WaterScope-Org/electronics/LED Defogger board/led_defogger_PCB_with_UV_jlc_bom.csv

Comment | Designator | Footprint | LCSC Part number
1 uF | C1, C2, C3, C4, C5, C6 | C_0805 | C28323
white | D1, D2, D3, D4, D5, D6 | LED_0603 | C389521
UV led | LED1, LED2 | F3500041 | C909692
56 | R1, R2, R3, R4, R5, R6, R7, R8 | R_1210 | C72399
510 | R12, R13, R14, R15, R16, R17 | R_0805 | C17734
10k | R10, R11 | R_0805 | C17414
60.4 | R9, R18 | R_1206 | C247280
DS18B20Z+ | IC3 | SOIC-8_3.9x4.9x1.27P | C695837
NCE6005AS | Q1 | SOP-8_3.9x4.9x1.27P | C126151
TAJB107K006RNJ | C7 | CASE-B_3528 | C16133
