WaterScope-Org/electronics/Incubator Breakout Board/incubator_breakout.step

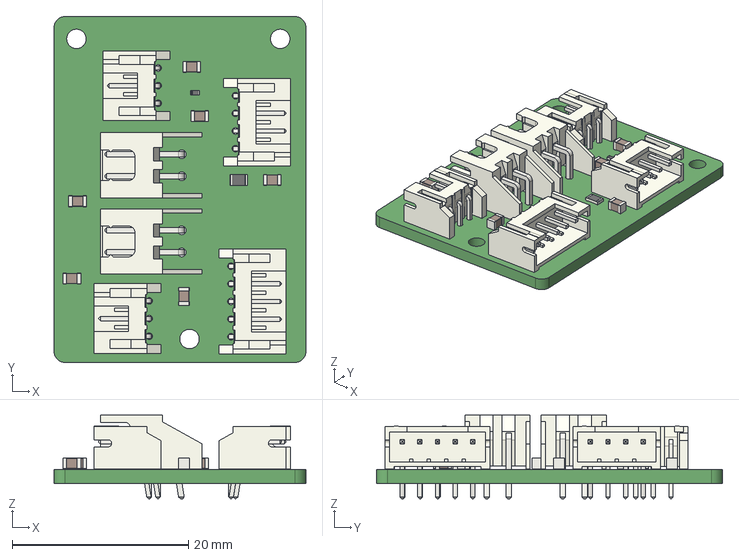
[picture p1: CAD file, 2023-12-29]
Incubator Breakout Board/incubator_breakout.step
28.6 x 39.2 x 9.50 mm
