WaterScope-Org/electronics/LED Defogger board/JST_-_B2B-PH-SM4-TB(LF)(SN).step

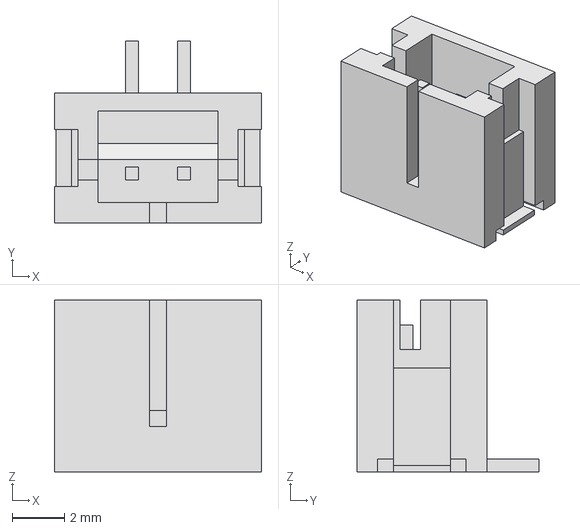
[picture p2: CAD file, 2023-12-29]
LED Defogger board/JST_-_B2B-PH-SM4-TB(LF)(SN).step
7.95 x 7.00 x 6.60 mm
