WaterScope-Org/electronics/Pump Board/cutout.dxf

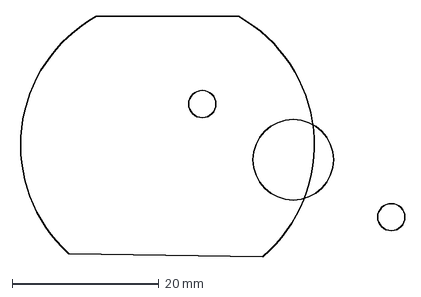
[picture p3: CAD file, 2023-12-29]
Pump Board/cutout.dxf
52.9 x 32.7 mm
