WaterScope-Org/electronics/UVC Sterilisation Boad/Updated Catridge Bottom.step

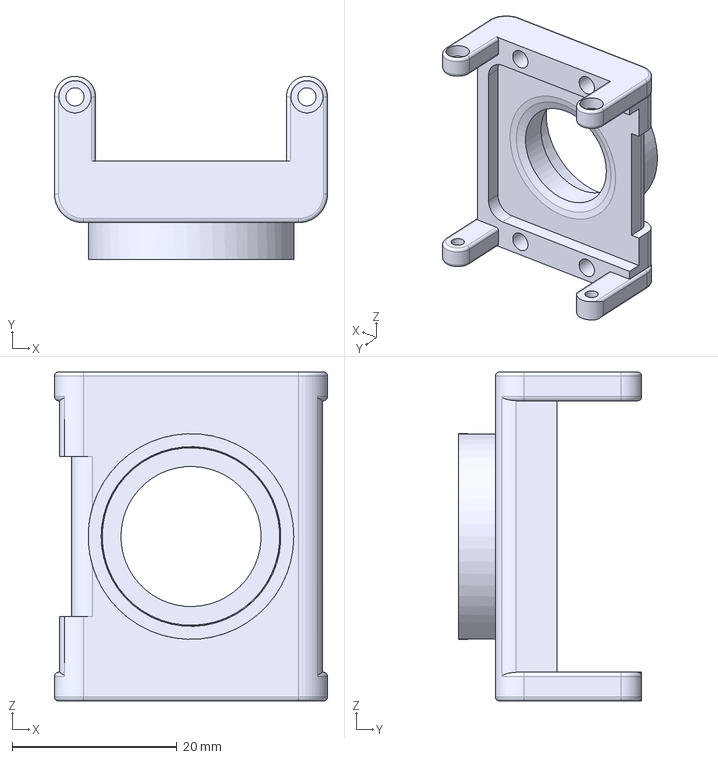
[picture p4: CAD file, 2023-12-29]
UVC Sterilisation Boad/Updated Catridge Bottom.step
33.2 x 22.3 x 40.0 mm
