WaterScope-Org/electronics/LED Defogger board/logo.dxf

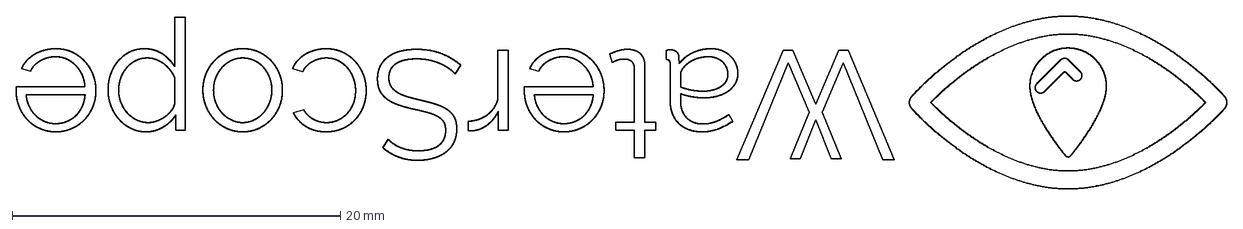
[picture p5: CAD file, 2023-12-29]
LED Defogger board/logo.dxf
73.8 x 10.5 mm
