WaterScope-Org/electronics/Pump Board/Pump PCB.step

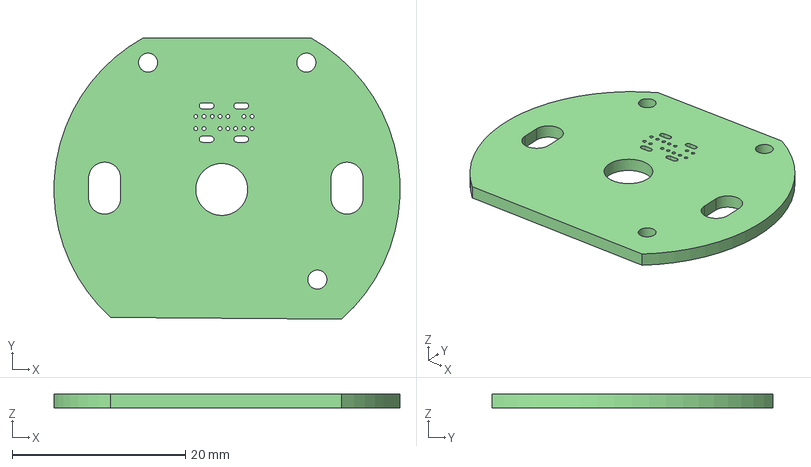
[picture p6: CAD file, 2023-12-29]
Pump Board/Pump PCB.step
40.0 x 32.5 x 1.60 mm
