WaterScope-Org/electronics/UVC Sterilisation Boad/holes.dxf

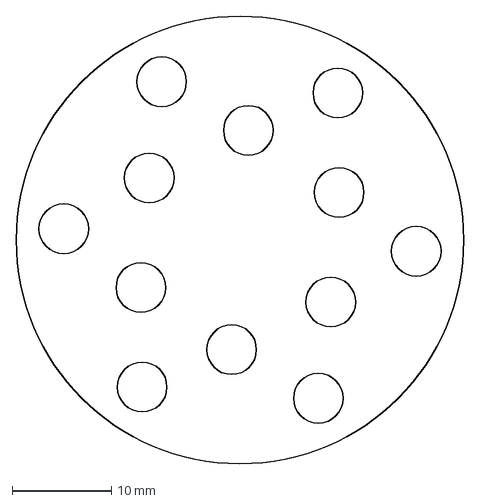
[picture p7: CAD file, 2023-12-29]
UVC Sterilisation Boad/holes.dxf
45.0 x 45.0 mm
