WaterScope-Org/electronics/LED Defogger board/led_defogger_PCB_with_UV.step

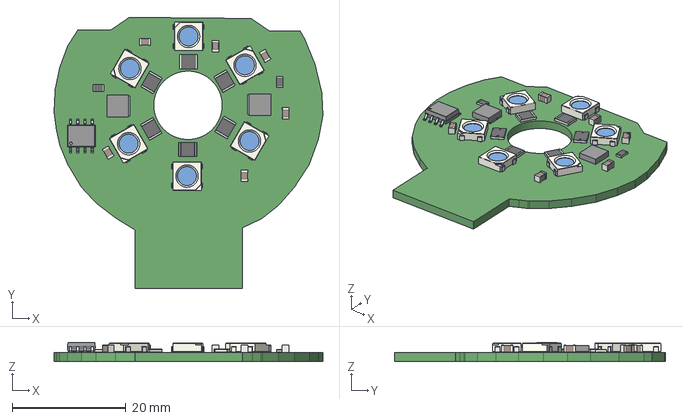
[picture p8: CAD file, 2023-12-29]
LED Defogger board/led_defogger_PCB_with_UV.step
47.2 x 47.6 x 3.40 mm
