WaterScope-Org/electronics/UVC Sterilisation Boad/outline.dxf

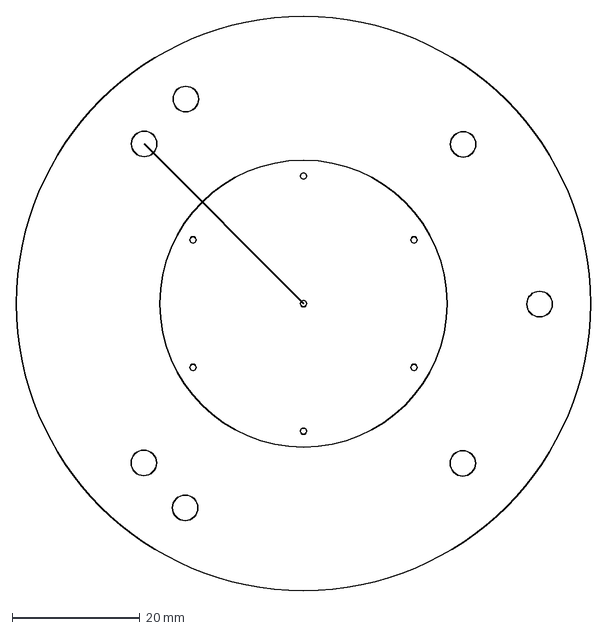
[picture p9: CAD file, 2023-12-29]
UVC Sterilisation Boad/outline.dxf
90.0 x 90.0 mm
