WaterScope-Org/electronics/LED Defogger board/led_defogger_PCB_with_UV_mounting.step

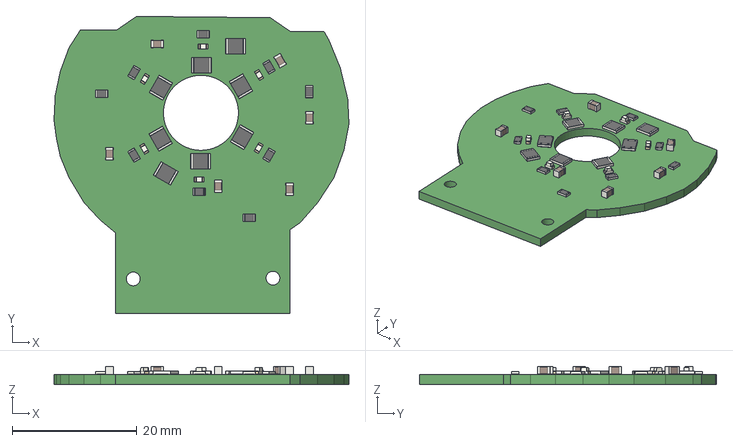
[picture p10: CAD file, 2023-12-29]
LED Defogger board/led_defogger_PCB_with_UV_mounting.step
47.2 x 47.5 x 2.90 mm
