WaterScope-Org/electronics/UVC Sterilisation Boad/Bottom (2).step

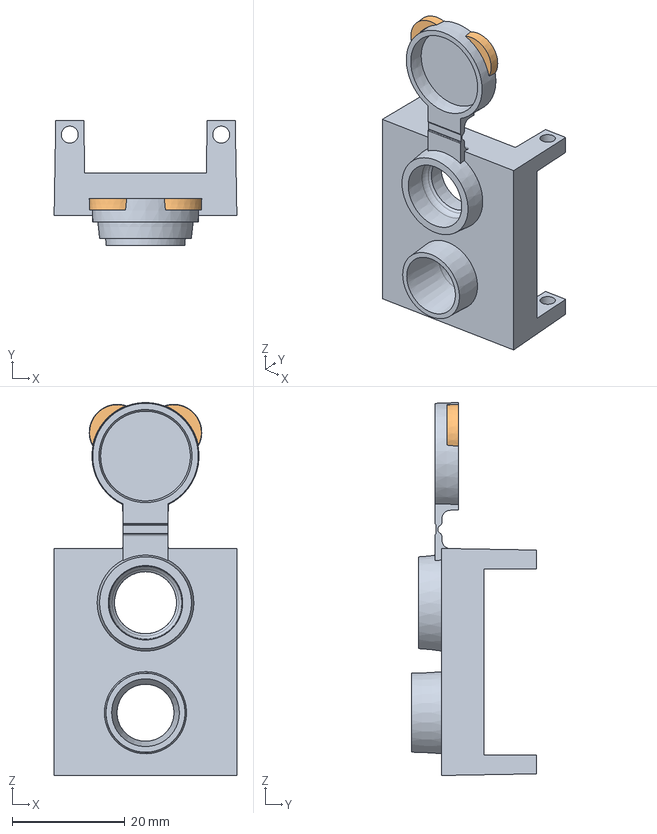
[picture p11: CAD file, 2023-12-29]
UVC Sterilisation Boad/Bottom (2).step
32.4 x 22.1 x 66.1 mm
