WaterScope-Org/electronics/LED Defogger board/JST_-_B6B-PH-SM4-TB(LF)(SN).step

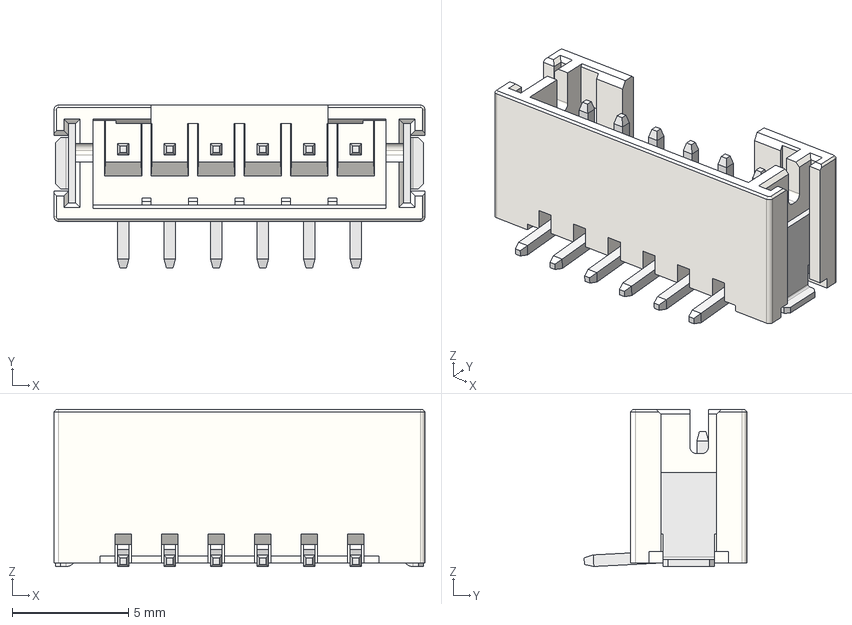
[picture p12: CAD file, 2023-12-29]
LED Defogger board/JST_-_B6B-PH-SM4-TB(LF)(SN).step
16.0 x 7.00 x 6.75 mm
