WaterScope-Org/electronics/UVC Sterilisation Boad/Updated Media Cap.step

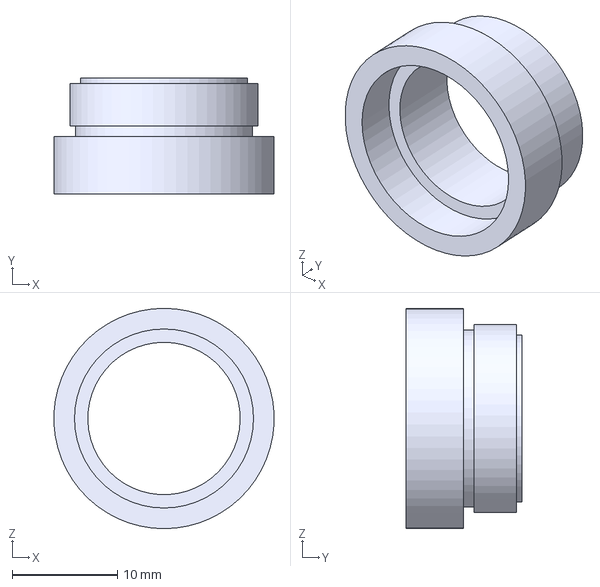
[picture p13: CAD file, 2023-12-29]
UVC Sterilisation Boad/Updated Media Cap.step
20.9 x 11.0 x 21.0 mm
