WaterScope-Org/electronics/LED Defogger board/led_defogger_PCB_with_UV_2022.step

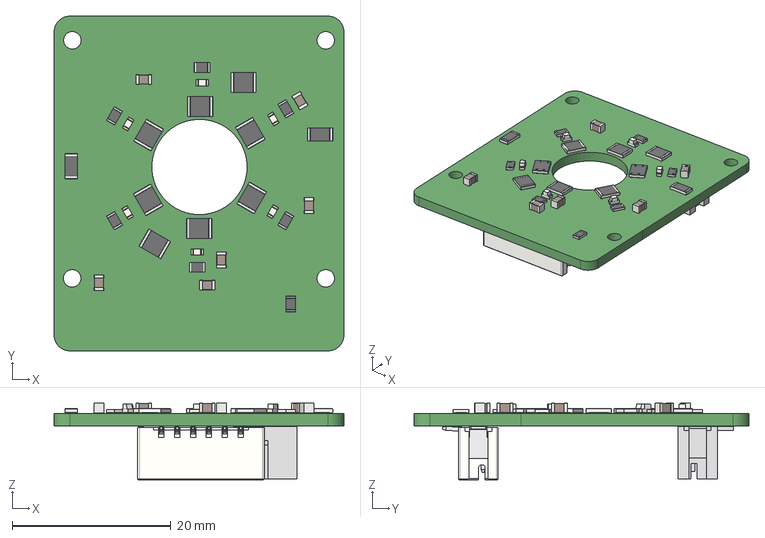
[picture p14: CAD file, 2023-12-29]
LED Defogger board/led_defogger_PCB_with_UV_2022.step
36.5 x 42.2 x 9.70 mm
