WaterScope-Org/electronics/UVC Sterilisation Boad/HRO TYPE-C-31-M-12.step

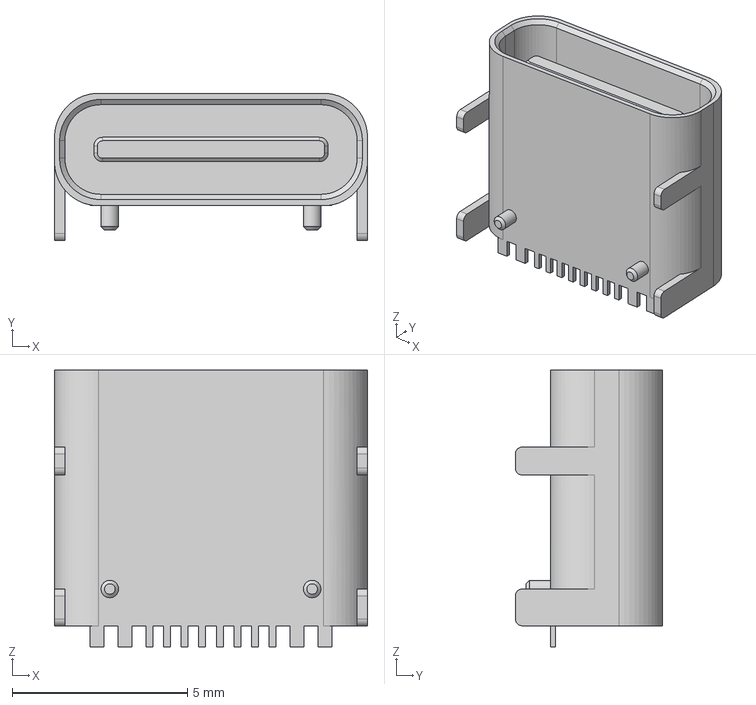
[picture p15: CAD file, 2023-12-29]
UVC Sterilisation Boad/HRO TYPE-C-31-M-12.step
8.94 x 4.21 x 7.90 mm
