WaterScope-Org/electronics/UVC Sterilisation Boad/Sterilization stick.step

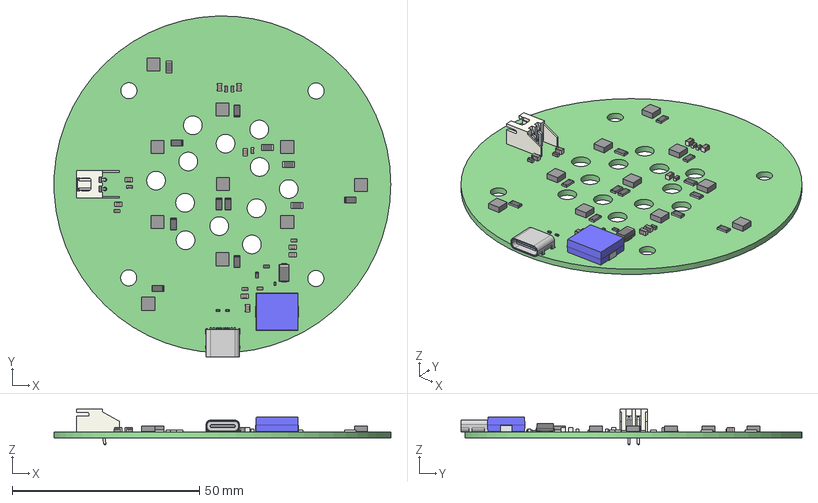
[picture p16: CAD file, 2023-12-29]
UVC Sterilisation Boad/Sterilization stick.step
89.9 x 91.1 x 9.50 mm
Sterilization stick PCB
