WaterScope-Org/electronics/UVC Sterilisation Boad/Media CapCap.step

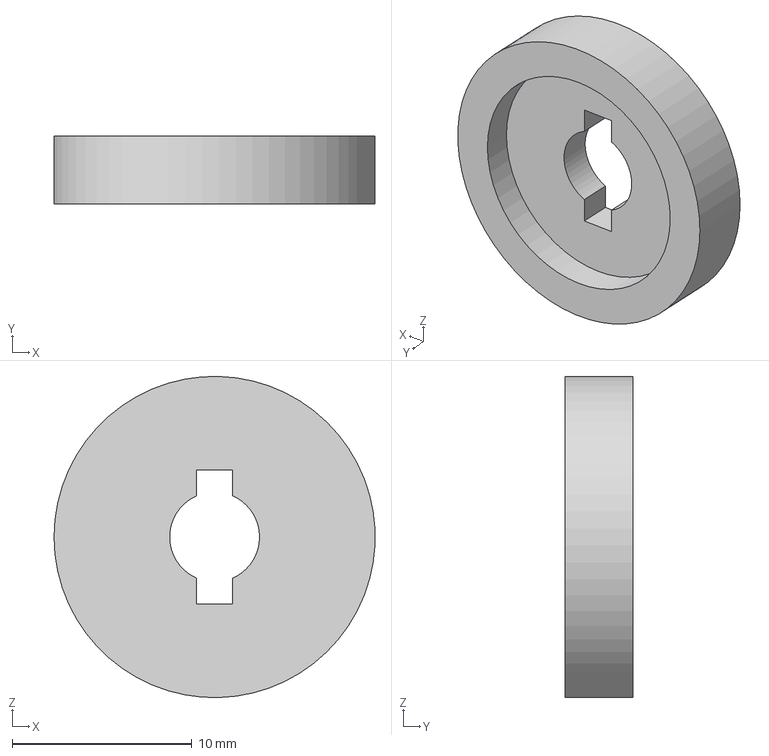
[picture p17: CAD file, 2023-12-29]
UVC Sterilisation Boad/Media CapCap.step
17.9 x 3.80 x 17.9 mm
