WaterScope-Org/electronics/Main Control Board/surface_mount_v4.kicad_pcb

## KiCad design Main Control Board/surface_mount_v4.kicad_pcb (2023-12-29)

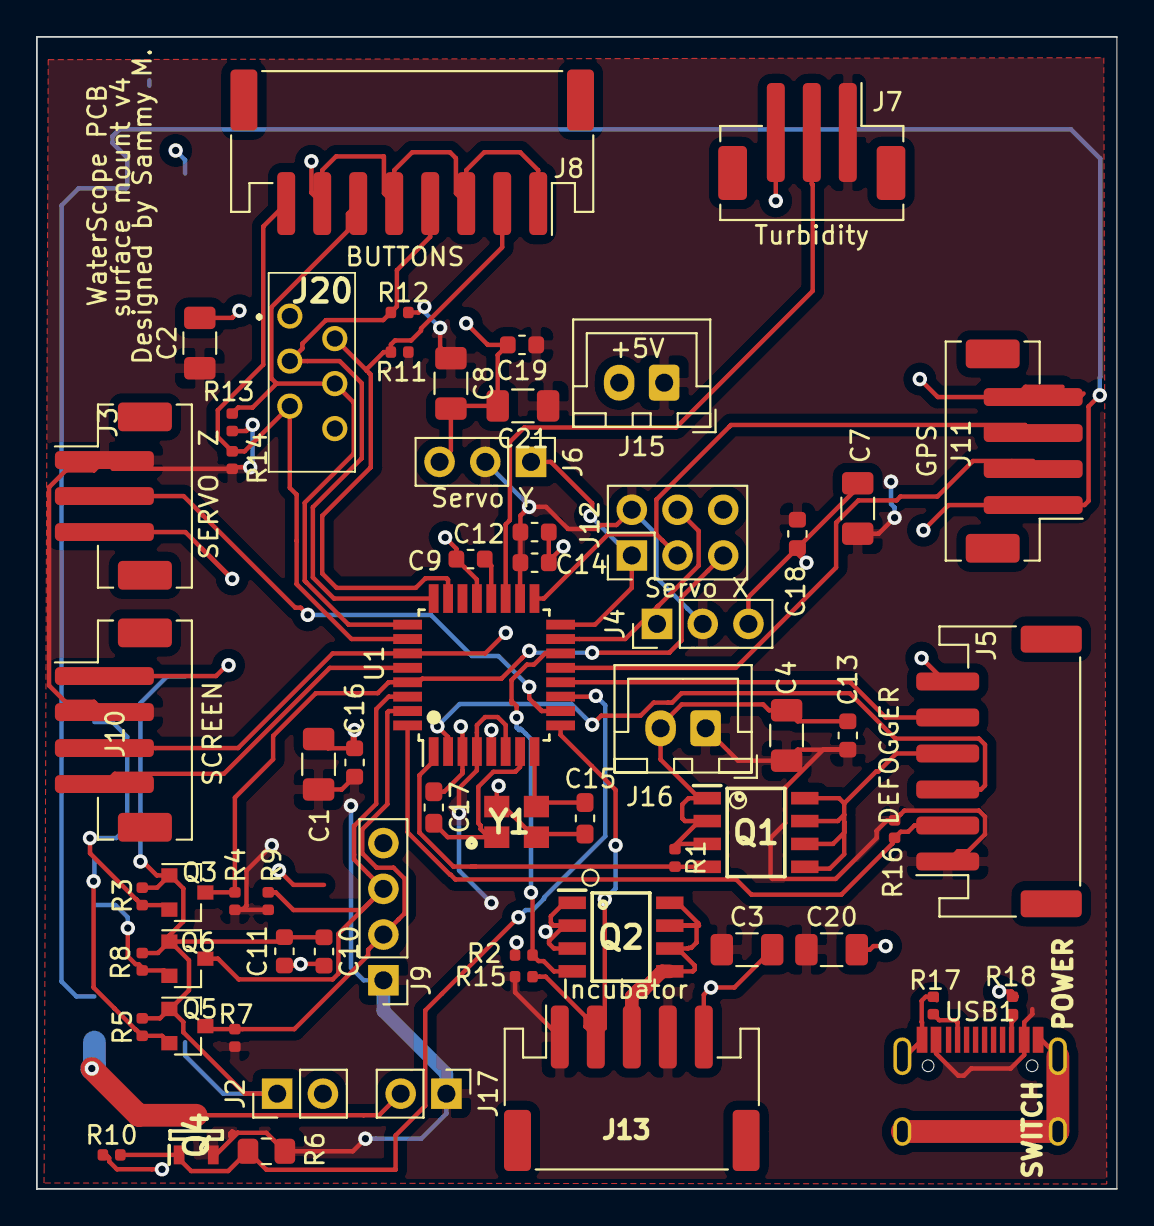
[picture p18: board surface_mount_v4.kicad_pcb from above]

Board: 2 copper layers, 60.0 x 64.0 mm, 63 parts (1 on the bottom side), 36 nets.

Parts:
C1, C2, C3, C4, C7, C8, C20, C21: 100 uF; R_1206_3216Metric
C9, C10, C13, C14, C16, C18, C19: 100nF; C_0603_1608Metric
C11, C12: 1uF; C_0603_1608Metric
C15, C17: 22pf; C_0603_1608Metric_Pad1.05x0.95mm_HandSolder
J1: Raspberry_Pi_2_3; PinSocket_2x20_P2.54mm_Vertical_SMD
J2, J17: Conn_01x02_Female; PinHeader_1x02_P2.54mm_Vertical
J3, J7: Z; JST_PH_B3B-PH-SM4-TB_1x03-1MP_P2.00mm_Vertical
J4, J6: Z; PinHeader_1x03_P2.54mm_Vertical
J5: Defogger; JST_PH_S6B-PH-SM4-TB_1x06-1MP_P2.00mm_Horizontal
J8: Conn_01x08_Female; JST_PH_S8B-PH-SM4-TB_1x08-1MP_P2.00mm_Horizontal
J9: Conn_01x04_Female; PinHeader_1x04_P2.54mm_Vertical
J10, J11: Conn_01x04_Female; JST_PH_B4B-PH-SM4-TB_1x04-1MP_P2.00mm_Vertical
J12: Conn_02x03_Odd_Even; PinHeader_2x03_P2.54mm_Vertical
J13: Incubator; JST_PH_S5B-PH-SM4-TB_1x05-1MP_P2.00mm_Horizontal
J15, J16: Conn_01x02_Female; JST_XH_B2B-XH-A_1x02_P2.50mm_Vertical
J20: Conn_01x08_Female; 06FEBTVKN
Q1, Q2: NTMS4807NR2G; SOIC127P600X175-8N
Q3, Q5, Q6: BSS138; SOT-23
Q4: PMV48XP,215; SOT95P230X110-3N
R1, R2, R3, R4, R5, R7, R8, R9, R10, R11, R12, R13, R14: 10K; R_0402_1005Metric
R6: 0K; R_0805_2012Metric_Pad1.15x1.40mm_HandSolder
R15, R16, R17, R18: 5.1K; R_0402_1005Metric
U1: ATmega328P-AU; TQFP-32_7x7mm_P0.8mm
USB1: HRO-TYPE-C-31-M-12; HRO-TYPE-C-31-M-12-Assembly
Y1: X322516MLB4SI

Connections:
+3V3: C10.1, C11.2, J1.1, J1.17, J2.1, Q3.1, Q5.1, Q6.1, R3.1, R5.1, R8.1
+5V: C1.1, C2.1, C3.1, C4.1, C7.1, C8.1, C12.1, C13.1, C14.1, C16.1, C18.1, C19.1, C20.1, C21.1, J3.1, J4.2, J5.1, J6.2, J7.1, J9.1, J10.2, J12.2, J13.1, J13.4, J15.1, J16.1, J17.1, Q4.2, R4.1, R6.1, R7.1, R9.1, R11.1, R12.1, R13.1, R14.1, R15.1, R16.1, U1.4, U1.6, U1.18, USB1.2, USB1.11
/ARx: J9.3, Q6.3, R9.2, U1.30
/ATx: J9.2, Q5.3, R7.2, U1.31
/BUT1: J8.2, J20.2, R11.2, U1.23
/BUT2: J8.4, J20.3, R12.2, U1.24
/BUT3: J8.6, J20.4, R13.2, U1.25
/BUT4: J8.8, J20.5, R14.2, U1.26
/GPS_Rx: J11.2, U1.13
/GPS_Tx: J11.3, J12.3, U1.17
/H-: J5.4, Q1.5, Q1.6, Q1.7, Q1.8
/H_control: Q1.4, R1.2, U1.1
/K-: J13.3, Q2.5, Q2.6, Q2.7, Q2.8
/K_control: Q2.4, R2.2, U1.14
/LED: J5.3, U1.2
/P_control: Q4.1, R6.2, R10.1, U1.11
/RRx: J1.10, Q5.2, R5.2
/RTx: J1.8, Q6.2, R8.2
/Reset: J12.5, Q3.3, R4.2, U1.29
/SCL: J10.4, U1.28
/SDA: J10.3, U1.27
/Temp_1: J5.2, R16.2, U1.32
/Temp_2: J13.2, R15.2, U1.9
/Turbidity: J7.2, U1.19
/UV: J5.5, U1.12
/rReset: J1.16, Q3.2, R3.2
/servo_x: J4.1, J12.4, U1.15
/servo_y: J6.1, J12.1, U1.16
/servo_z: J3.2, U1.10
GND: C1.2, C2.2, C3.2, C4.2, C7.2, C8.2, C9.2, C10.2, C11.1, C12.2, C13.2, C14.2, C15.2, C16.2, C17.1, C18.2, C19.2, C20.2, C21.2, J1.39, J2.2, J3.3, J4.3, J5.6, J6.3, J7.3, J8.1, J8.3, J8.5, J8.7, J9.4, J10.1, J11.4, J12.6, J13.5, J15.2, J16.2, J20.1, J20.6, Q1.1, Q1.2, Q1.3, Q2.1, Q2.2, Q2.3, R1.1, R2.1, R10.2, R17.2, R18.1, U1.3, U1.5, U1.21, USB1.1, USB1.12, USB1.13, Y1.2, Y1.4
unnamed: C9.1, U1.20
unnamed: C15.1, U1.8, Y1.3
unnamed: C17.2, U1.7, Y1.1
unnamed: R17.1, USB1.4
unnamed: R18.2, USB1.10
pi_5V: J1.2, J1.4, J11.1, J17.2, Q4.3
