WaterScope-Org/electronics/LED Defogger board/led_defogger_PCB_with_UV_2022.kicad_pcb

## KiCad design LED Defogger board/led_defogger_PCB_with_UV_2022.kicad_pcb (2023-12-29)

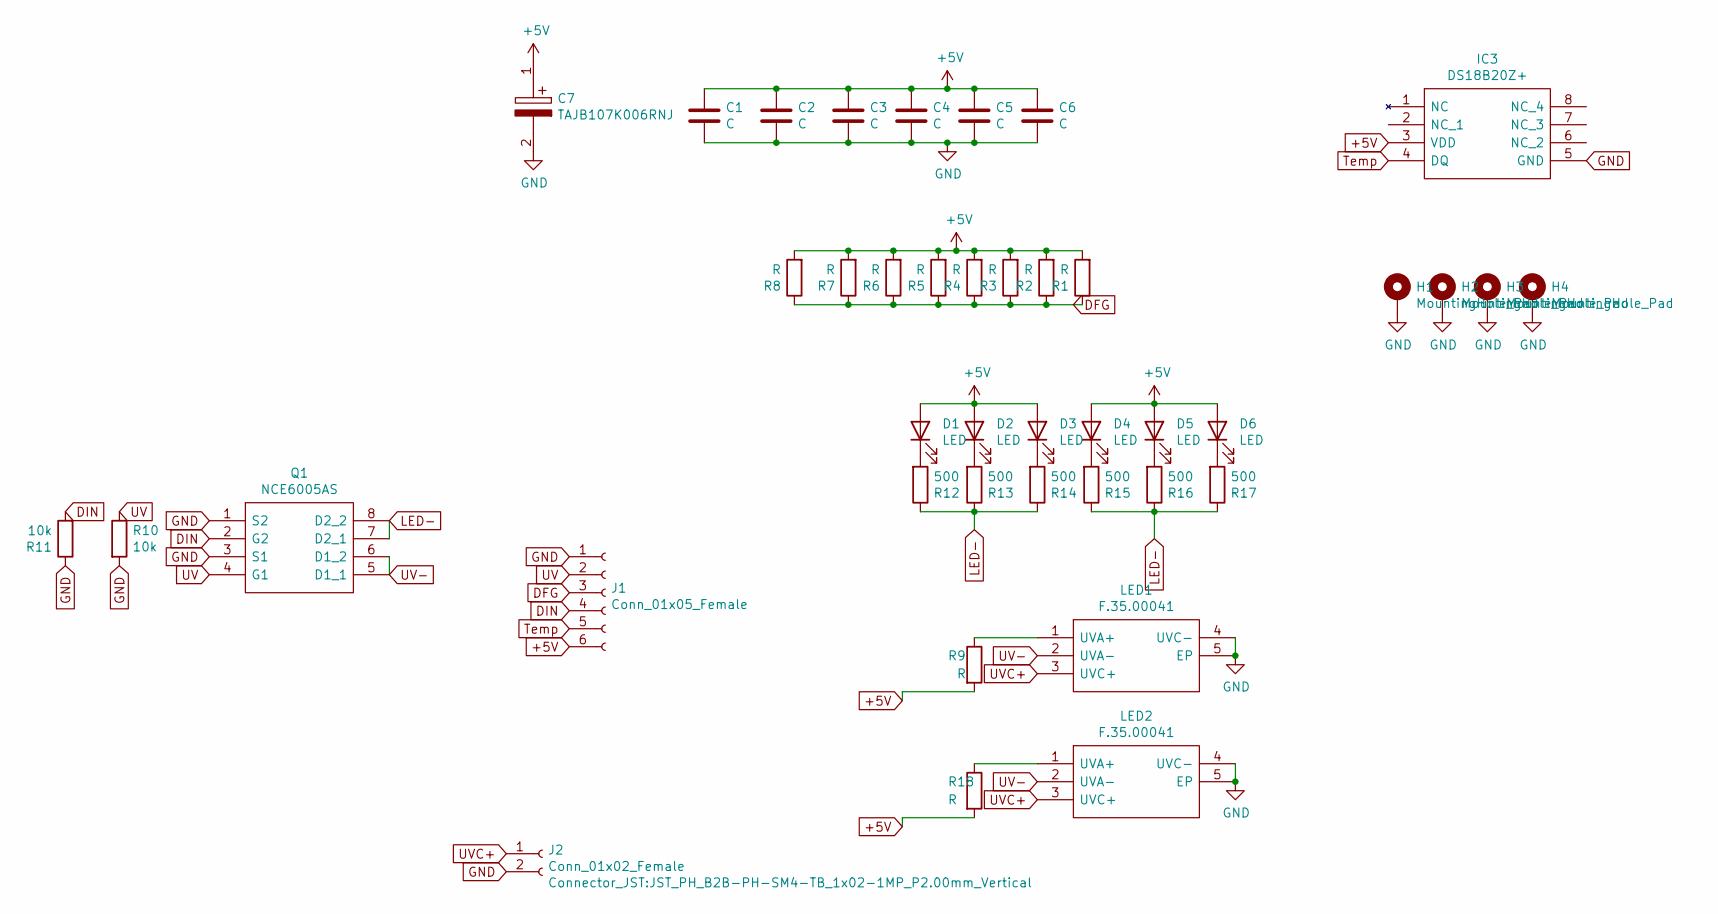
[picture p19: schematic led_defogger_PCB_with_UV_2022.sch]

Parts:
C1, C2, C3, C4, C5, C6: C; C_0805_2012Metric_Pad1.15x1.40mm_HandSolder
C7: TAJB107K006RNJ; CAPPM3528X210N; Manufacturer_Part_Number TAJB107K006RNJ; Mouser Part Number 581-TAJB107K006R
D1, D2, D3, D4, D5, D6: LED; LED_0603_1608Metric_Pad1.05x0.95mm_HandSolder
H1, H2, H3, H4: MountingHole_Pad; MountingHole_2.2mm_M2_DIN965_Pad
IC3: DS18B20Z+; SOIC127P600X175-8N; Manufacturer_Part_Number DS18B20Z+
J1: Conn_01x05_Female; JST_PH_B6B-PH-SM4-TB_1x06-1MP_P2.00mm_Vertical
J2: Conn_01x02_Female; JST_PH_B2B-PH-SM4-TB_1x02-1MP_P2.00mm_Vertical
LED1, LED2: F.35.00041; F3500041; Manufacturer_Part_Number F.35.00041
Q1: NCE6005AS; SOIC127P600X175-8N; Manufacturer_Part_Number NCE6005AS
R1, R2, R3, R4, R5, R6, R7, R8: R; R_1210_3225Metric_Pad1.42x2.65mm_HandSolder
R9, R18: R; R_1206_3216Metric_Pad1.30x1.75mm_HandSolder
R10, R11: 10k; R_0805_2012Metric_Pad1.15x1.40mm_HandSolder
R12, R13, R14, R15, R16, R17: 500; R_0805_2012Metric_Pad1.15x1.40mm_HandSolder

Connections:
+5V: C1.1, C2.1, C3.1, C4.1, C5.1, C6.1, C7.1, D1.2 (A), D2.2 (A), D3.2 (A), D4.2 (A), D5.2 (A), D6.2 (A), IC3.3 (VDD), J1.6, R1.2, R2.2, R3.2, R4.2, R5.2, R6.2, R7.2, R8.2, R9.2, R18.2
DFG: J1.3, R1.1, R2.1, R3.1, R4.1, R5.1, R6.1, R7.1, R8.1
DIN: J1.4, Q1.2 (G2), R11.2
GND: C1.2, C2.2, C3.2, C4.2, C5.2, C6.2, C7.2, H1.1, H2.1, H3.1, H4.1, IC3.5 (GND), J1.1, J2.2, LED1.4 (UVC-), LED1.5 (EP), LED2.4 (UVC-), LED2.5 (EP), Q1.1 (S2), Q1.3 (S1), R10.2, R11.1
LED-: Q1.7 (D2_1), Q1.8 (D2_2), R12.1, R13.1, R14.1, R15.1, R16.1, R17.1
unnamed: D1.1 (K), R12.2
unnamed: D2.1 (K), R13.2
unnamed: D3.1 (K), R14.2
unnamed: D4.1 (K), R15.2
unnamed: D5.1 (K), R16.2
unnamed: D6.1 (K), R17.2
unnamed: LED1.1 (UVA+), R9.1
unnamed: LED2.1 (UVA+), R18.1
Temp: IC3.4 (DQ), J1.5
UV: J1.2, Q1.4 (G1), R10.1
UV-: LED1.2 (UVA-), LED2.2 (UVA-), Q1.5 (D1_1), Q1.6 (D1_2)
UVC+: J2.1, LED1.3 (UVC+), LED2.3 (UVC+)

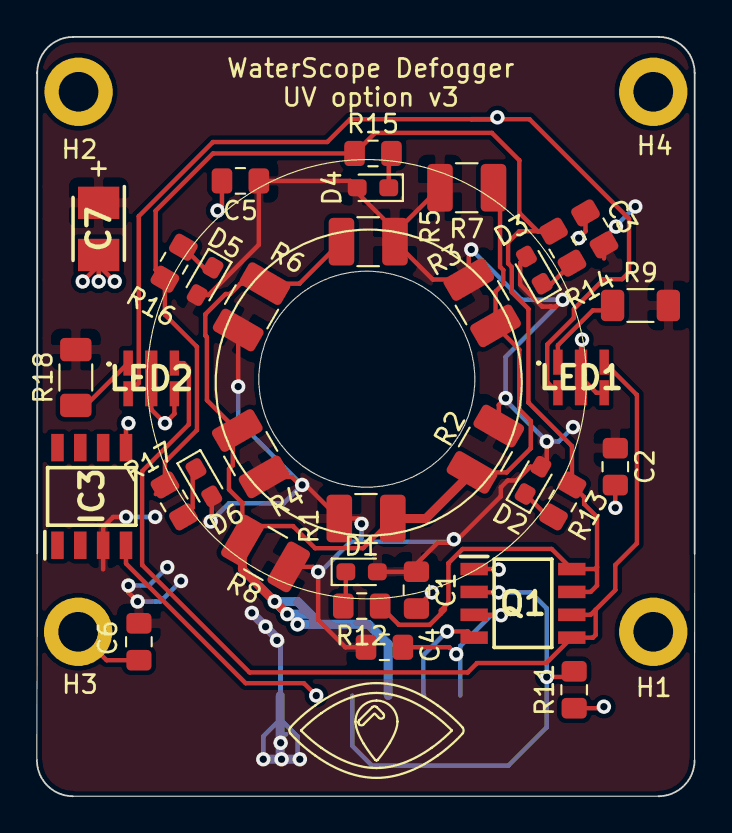
[picture p20: board led_defogger_PCB_with_UV_2022.kicad_pcb from above]

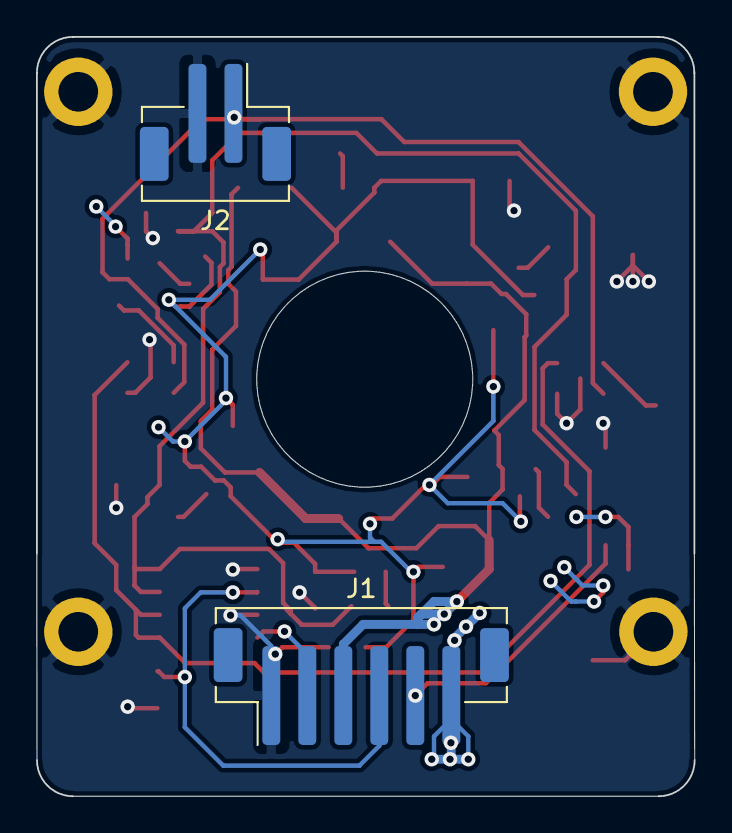
[picture p21: board led_defogger_PCB_with_UV_2022.kicad_pcb from below]

Board: 2 copper layers, 36.5 x 42.2 mm, 40 parts (2 on the bottom side), 17 nets.
