WaterScope-Org/electronics/Pump Board/Pump PCB.kicad_pcb

## KiCad design Pump Board/Pump PCB.kicad_pcb (2023-12-29)

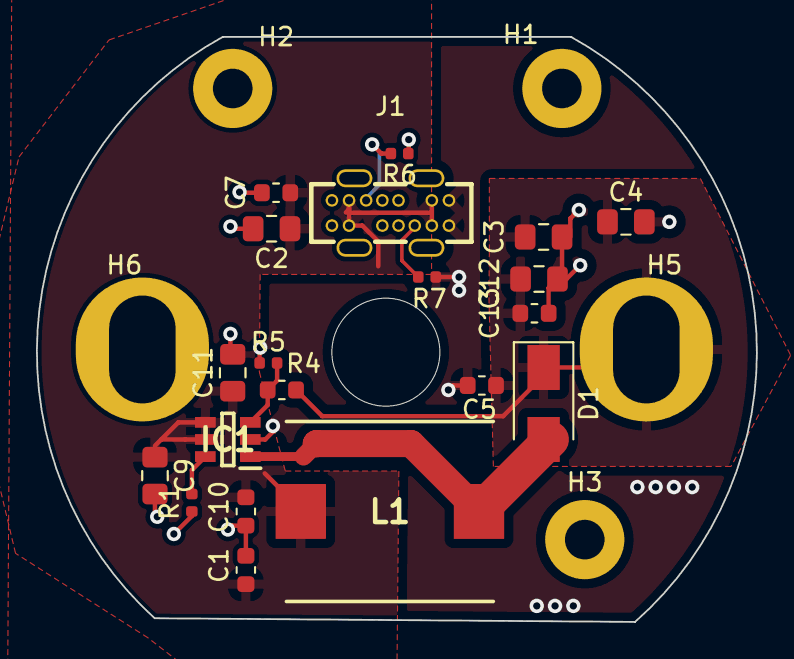
[picture p22: board Pump PCB.kicad_pcb from above]

Board: 2 copper layers, 40.0 x 32.5 mm, 25 parts (0 on the bottom side), 8 nets.

Parts:
C1, C5, C7, C10, C13: 0.1uF; C_0603_1608Metric
C2, C3, C4, C9, C11, C12: 20uF; C_0805_2012Metric_Pad1.15x1.40mm_HandSolder
D1: D_Schottky; D_SMA
H1, H2, H3: MountingHole; MountingHole_2.2mm_M2_Pad
H5, H6: MountingHole_Pad; MountingHole_3.7mm_Pad
IC1: FP6291; SOT95P280X145-6N
J1: USB-C-TH_TYPE-C-USB-14P
L1: SMMS1040-3R3M; INDPM115100X400N
R1, R5: 10K; R_0402_1005Metric
R4: 190K; R_0603_1608Metric
R6: 5.1k; R_0402_1005Metric
R7: 5.1K; R_0402_1005Metric

Connections:
5V: C1.1, C2.1, C7.1, C9.1, C10.1, C11.1, IC1.4, IC1.5, J1.2, J1.6, J1.9, J1.13, L1.1
12V: C3.1, C4.1, C5.1, C12.1, C13.1, D1.1, H5.1, R4.2
GND: C1.2, C2.2, C3.2, C4.2, C5.2, C7.2, C9.2, C10.2, C11.2, C12.2, C13.2, H6.1, IC1.2, J1.1, J1.7, J1.8, J1.14, R1.2, R5.1, R6.1, R7.2
unnamed: D1.2, IC1.1, L1.2
unnamed: IC1.3, R4.1, R5.2
unnamed: IC1.6, R1.1
unnamed: J1.5, R7.1
unnamed: J1.12, R6.2
