WaterScope-Org/electronics/UVC Sterilisation Boad/Sterilization stick.kicad_pcb

## KiCad design UVC Sterilisation Boad/Sterilization stick.kicad_pcb (2023-12-29)

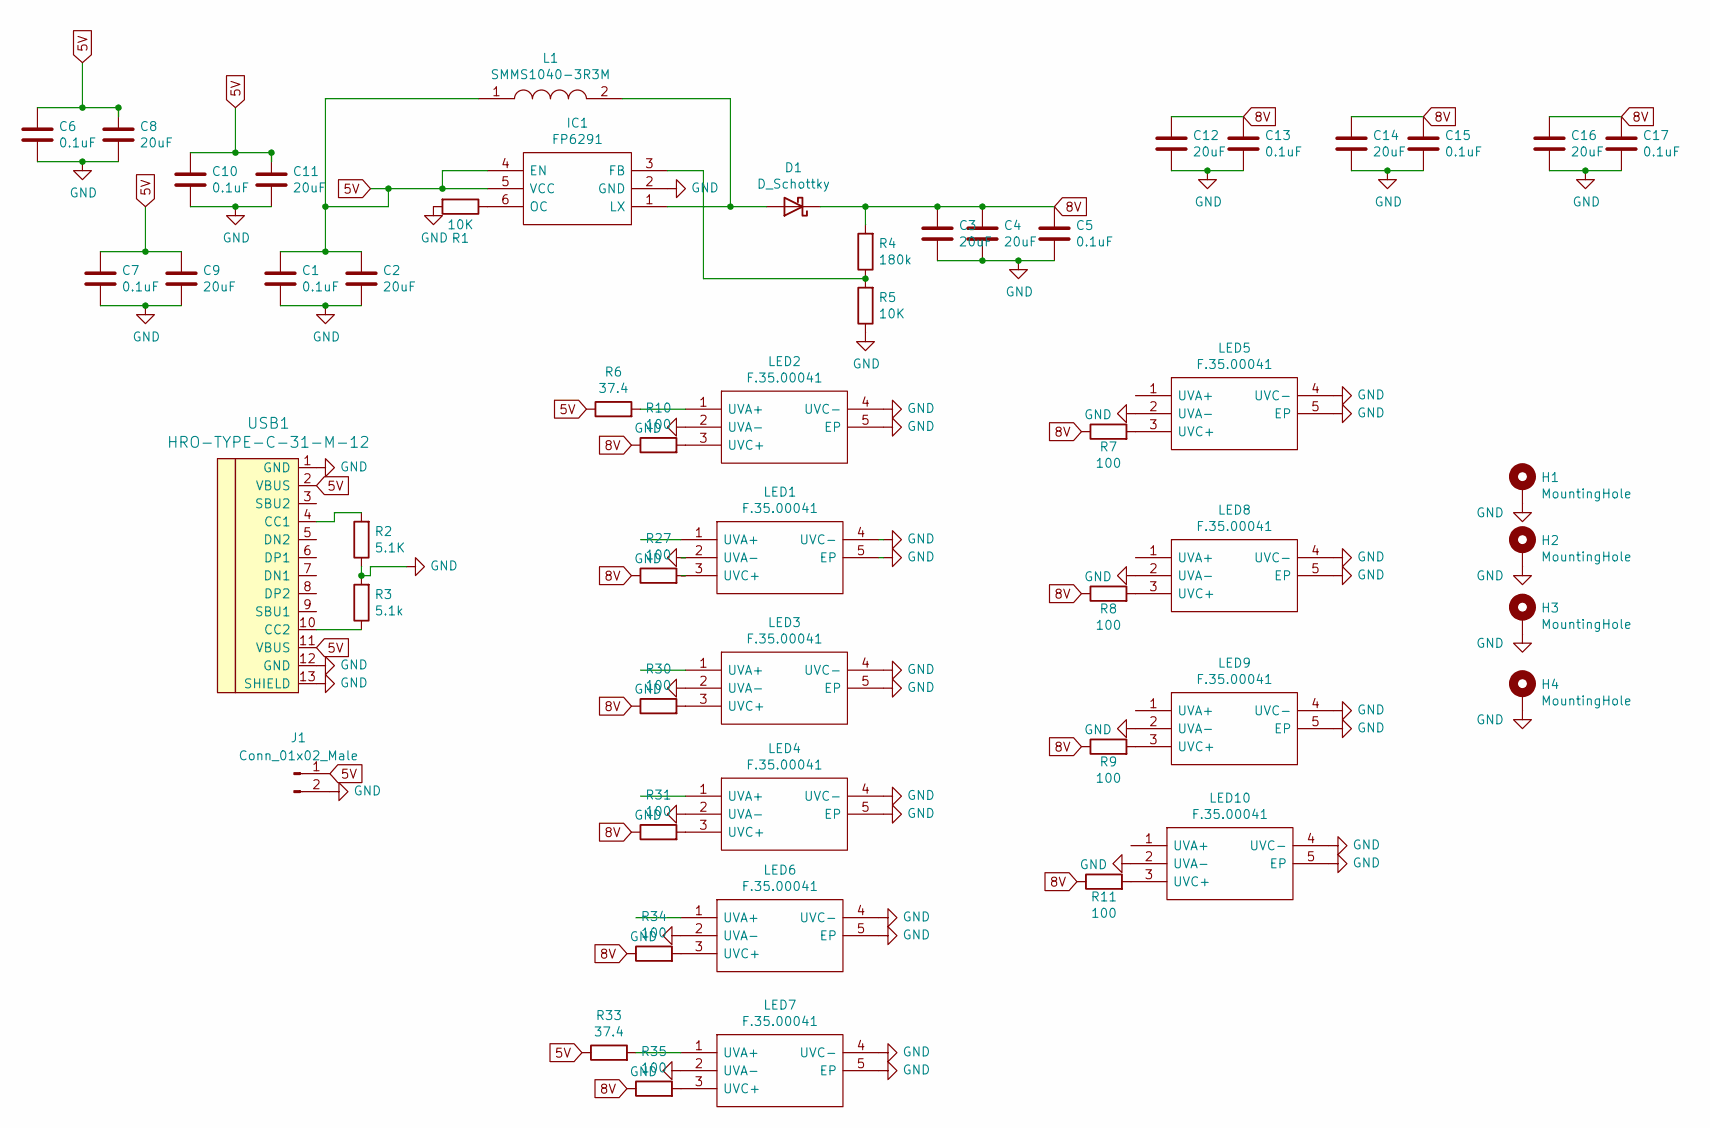
[picture p23: schematic Sterilization stick.kicad_sch]

Parts:
C1, C5, C6, C7, C10, C13, C15, C17: 0.1uF; C_0603_1608Metric; LCSC Part C14663
C2, C3, C4, C8, C9, C11, C12, C14, C16: 20uF; C_0805_2012Metric_Pad1.15x1.40mm_HandSolder; LCSC Part C45783
D1: D_Schottky; D_SMA; LCSC Part C383313
H1, H2, H3, H4: MountingHole; MountingHole_4.3mm_M4_DIN965_Pad
IC1: FP6291; SOT95P280X145-6N; Manufacturer_Part_Number FP6291; LCSC Part C18701
J1: Conn_01x02_Male; JST_XH_S2B-XH-A-1_1x02_P2.50mm_Horizontal
L1: SMMS1040-3R3M; INDPM115100X400N; Manufacturer_Part_Number SMMS1040-3R3M; LCSC Part C149592
LED1, LED2, LED3, LED4, LED5, LED6, LED7, LED8, LED9, LED10: F.35.00041; F3500041; Manufacturer_Part_Number F.35.00041; LCSC Part C909692
R1: 10K; R_0402_1005Metric; LCSC Part C25744
R2: 5.1K; R_0402_1005Metric; LCSC Part C25905
R3: 5.1k; R_0402_1005Metric; LCSC Part C25905
R4: 180k; R_0603_1608Metric; LCSC Part C22932
R5: 10K; R_0603_1608Metric_Pad0.98x0.95mm_HandSolder; LCSC Part C25744
R6, R33: 37.4; R_1206_3216Metric; LCSC Part C247280
R7, R8, R9, R10, R11, R27, R30, R31, R34, R35: 100; R_1206_3216Metric; LCSC Part C17901
USB1: HRO-TYPE-C-31-M-12; HRO-TYPE-C-31-M-12-HandSoldering

Connections:
5V: C1.1, C2.1, C6.1, C7.1, C8.1, C9.1, C10.1, C11.1, IC1.4 (EN), IC1.5 (VCC), J1.1, L1.1, R6.1, R33.1, USB1.2 (VBUS), USB1.11 (VBUS)
8V: C3.1, C4.1, C5.1, C12.1, C13.1, C14.1, C15.1, C16.1, C17.1, D1.1 (K), R4.2, R7.1, R8.1, R9.1, R10.1, R11.1, R27.1, R30.1, R31.1, R34.1, R35.1
GND: C1.2, C2.2, C3.2, C4.2, C5.2, C6.2, C7.2, C8.2, C9.2, C10.2, C11.2, C12.2, C13.2, C14.2, C15.2, C16.2, C17.2, H1.1, H2.1, H3.1, H4.1, IC1.2 (GND), J1.2, LED1.2 (UVA-), LED1.4 (UVC-), LED1.5 (EP), LED2.2 (UVA-), LED2.4 (UVC-), LED2.5 (EP), LED3.2 (UVA-), LED3.4 (UVC-), LED3.5 (EP), LED4.2 (UVA-), LED4.4 (UVC-), LED4.5 (EP), LED5.2 (UVA-), LED5.4 (UVC-), LED5.5 (EP), LED6.2 (UVA-), LED6.4 (UVC-), LED6.5 (EP), LED7.2 (UVA-), LED7.4 (UVC-), LED7.5 (EP), LED8.2 (UVA-), LED8.4 (UVC-), LED8.5 (EP), LED9.2 (UVA-), LED9.4 (UVC-), LED9.5 (EP), LED10.2 (UVA-), LED10.4 (UVC-), LED10.5 (EP), R1.2, R2.1, R3.2, R5.1, USB1.1 (GND), USB1.12 (GND), USB1.13 (SHIELD)
unnamed: D1.2 (A), IC1.1 (LX), L1.2
unnamed: IC1.3 (FB), R4.1, R5.2
unnamed: IC1.6 (OC), R1.1
unnamed: LED1.3 (UVC+), R27.2
unnamed: LED2.1 (UVA+), R6.2
unnamed: LED2.3 (UVC+), R10.2
unnamed: LED3.3 (UVC+), R30.2
unnamed: LED4.3 (UVC+), R31.2
unnamed: LED5.3 (UVC+), R7.2
unnamed: LED6.3 (UVC+), R34.2
unnamed: LED7.1 (UVA+), R33.2
unnamed: LED7.3 (UVC+), R35.2
unnamed: LED8.3 (UVC+), R8.2
unnamed: LED9.3 (UVC+), R9.2
unnamed: LED10.3 (UVC+), R11.2
unnamed: R2.2, USB1.4 (CC1)
unnamed: R3.1, USB1.10 (CC2)

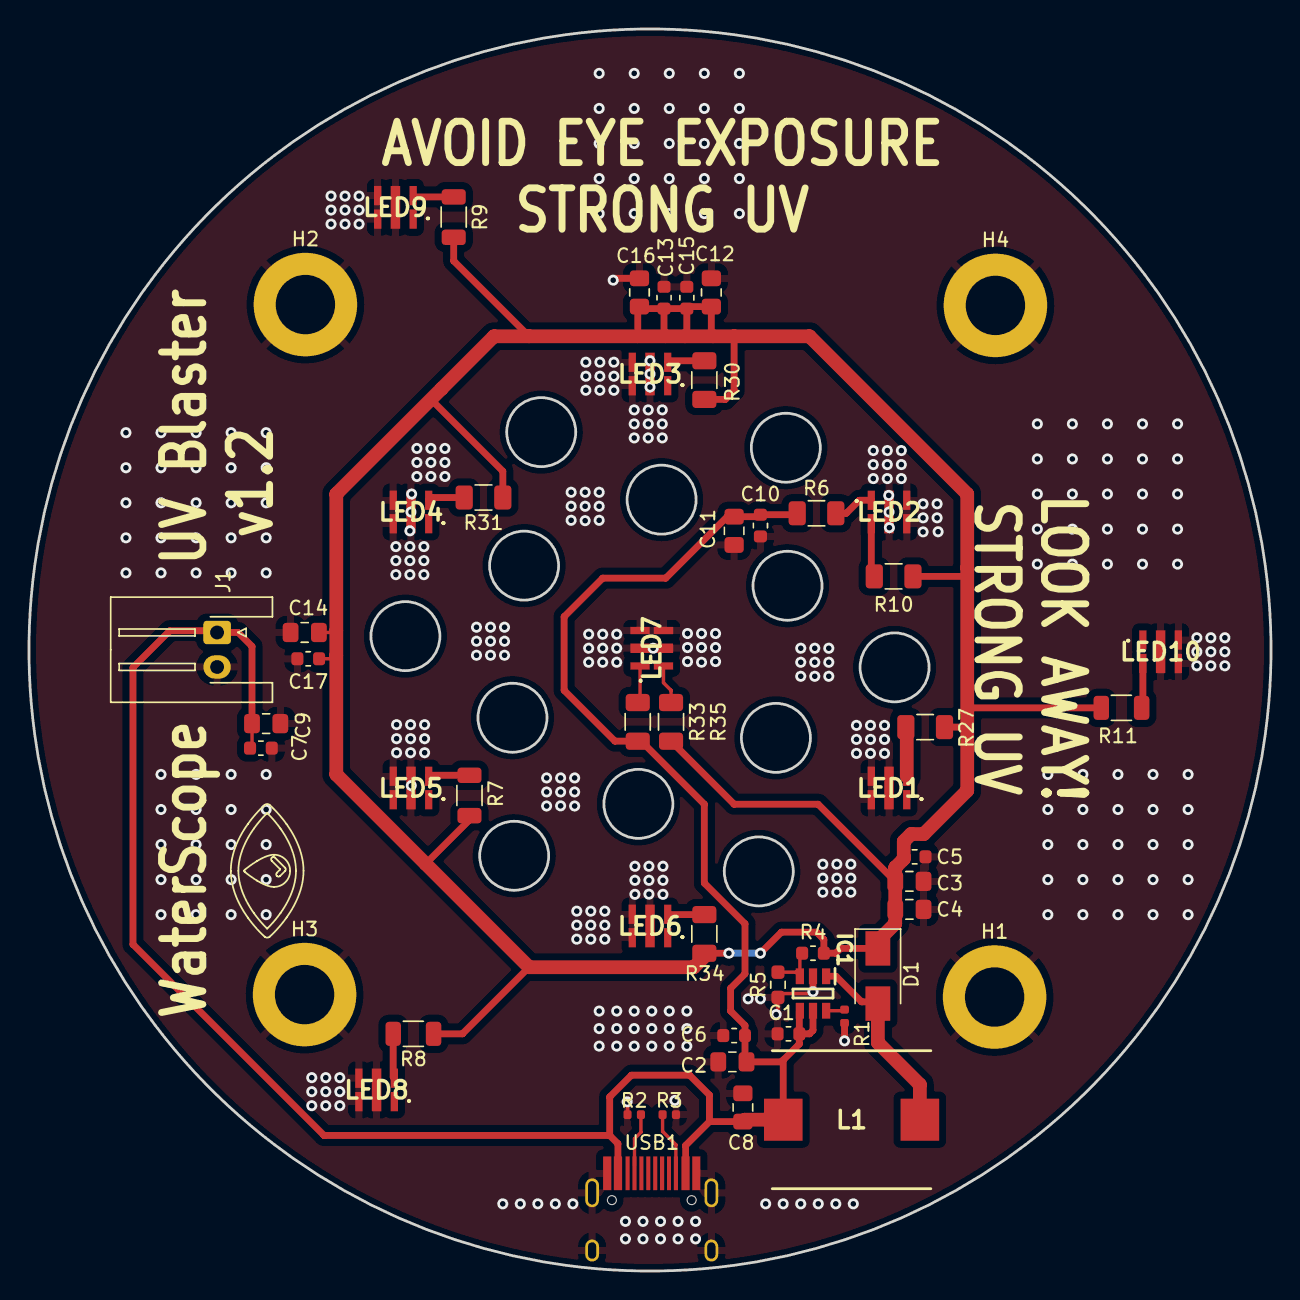
[picture p24: board Sterilization stick.kicad_pcb from above]

Board: 2 copper layers, 90.0 x 90.0 mm, 53 parts (0 on the bottom side), 20 nets.
