WaterScope-Org/electronics/Incubator Breakout Board/incubator_breakout.kicad_pcb

## KiCad design Incubator Breakout Board/incubator_breakout.kicad_pcb (2023-12-29)

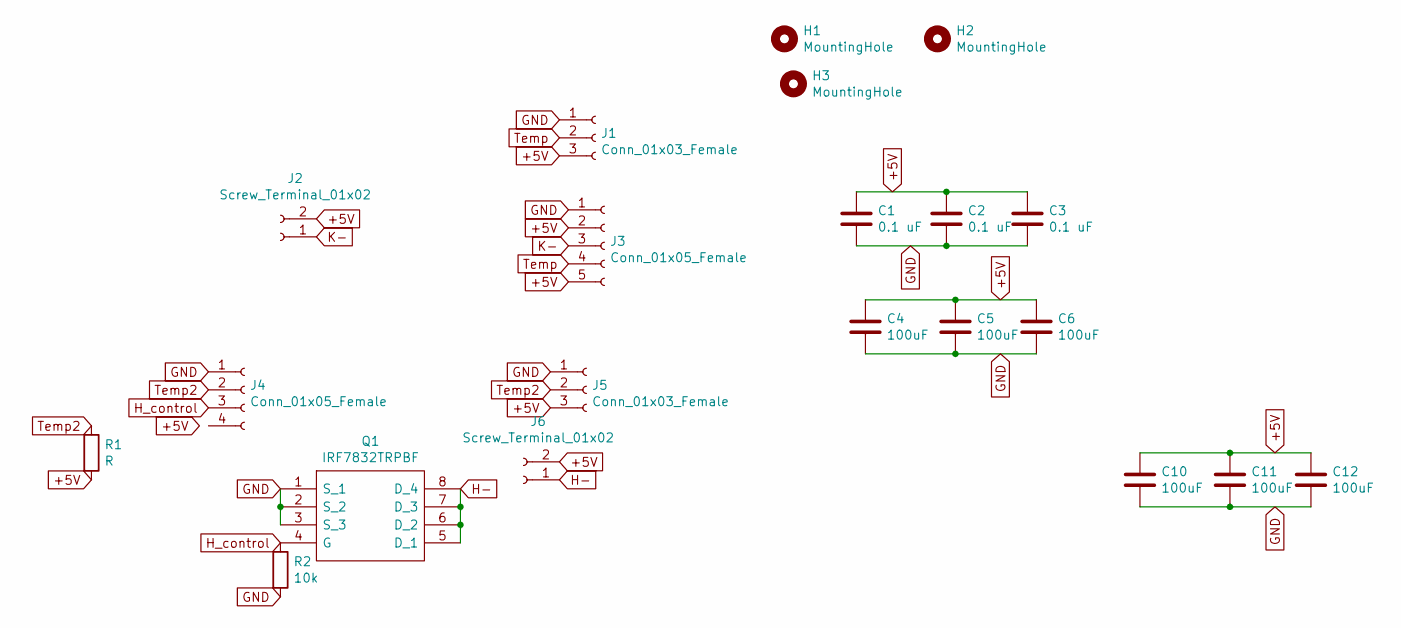
[picture p25: schematic incubator_breakout.kicad_sch]

Parts:
C1, C2, C3: 0.1 uF; C_0805_2012Metric_Pad1.15x1.40mm_HandSolder
C4, C5, C6: 100uF; C_0805_2012Metric_Pad1.15x1.40mm_HandSolder
C10, C11, C12: 100uF; C_0805_2012Metric_Pad1.18x1.45mm_HandSolder
H1, H2, H3: MountingHole; MountingHole_2.2mm_M2_Pad
J1, J5: Conn_01x03_Female; JST_PH_S3B-PH-K_1x03_P2.00mm_Horizontal
J2, J6: Screw_Terminal_01x02; JST_XH_S2B-XH-A_1x02_P2.50mm_Horizontal
J3: Conn_01x05_Female; JST_PH_S5B-PH-K_1x05_P2.00mm_Horizontal
J4: Conn_01x05_Female; JST_PH_S4B-PH-K_1x04_P2.00mm_Horizontal
Q1: IRF7832TRPBF; SOIC127P600X175-8N; Manufacturer_Part_Number NTMS4807NR2G; Mouser Part Number 863-NTMS4807NR2G
R1: R; R_0402_1005Metric
R2: 10k; R_0805_2012Metric_Pad1.15x1.40mm_HandSolder

Connections:
+5V: C1.1, C2.1, C3.1, C4.1, C5.1, C6.1, C10.1, C11.1, C12.1, J1.3, J2.2, J3.2, J3.5, J5.3, J6.2, R1.2
GND: C1.2, C2.2, C3.2, C4.2, C5.2, C6.2, C10.2, C11.2, C12.2, J1.1, J3.1, J4.1, J5.1, Q1.1 (S_1), Q1.2 (S_2), Q1.3 (S_3), R2.2
H-: J6.1, Q1.5 (D_1), Q1.6 (D_2), Q1.7 (D_3), Q1.8 (D_4)
H_control: J4.3, Q1.4 (G), R2.1
K-: J2.1, J3.3
Temp: J1.2, J3.4
Temp2: J4.2, J5.2, R1.1

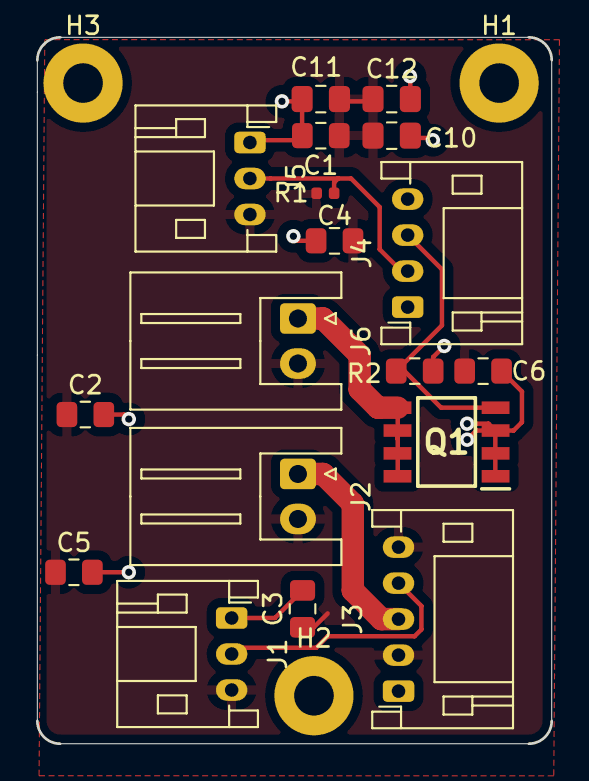
[picture p26: board incubator_breakout.kicad_pcb from above]

Board: 2 copper layers, 28.6 x 39.2 mm, 21 parts (0 on the bottom side), 7 nets.
